arturocontreras/Paracas_Robot/Interfaz SCADA/RP_V2/WindowsFormsApplication9/Resources/images.jpg

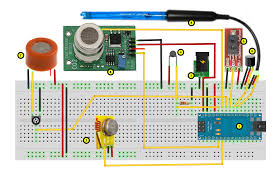
Interfaz SCADA/RP_V2/WindowsFormsApplication9/Resources/images.jpg
