arturocontreras/Paracas_Robot/Diseño Electronico/Placas/Gerber_ACS758_100A/ACS758_100A - CADCAM Bottom Solder Resist.TXT

G04 PROTEUS RS274X GERBER FILE*
%FSLAX24Y24*%
%MOIN*%
%ADD16R,0.1000X0.1000*%
%ADD14C,0.0080*%
G54D16*
X-40500Y+41500D03*
X-40500Y+40500D03*
X-40500Y+39500D03*
X-36500Y+41500D03*
X-36500Y+40500D03*
X-36500Y+39500D03*
G54D14*
X-59000Y+34500D02*
X-35000Y+34500D01*
X-35000Y+47000D01*
X-59000Y+47000D01*
X-59000Y+34500D01*
X-57500Y+35500D02*
X-57502Y+35540D01*
X-57515Y+35621D01*
X-57543Y+35702D01*
X-57588Y+35783D01*
X-57657Y+35864D01*
X-57738Y+35926D01*
X-57819Y+35966D01*
X-57900Y+35990D01*
X-57981Y+36000D01*
X-58000Y+36000D01*
X-58500Y+35500D02*
X-58498Y+35540D01*
X-58485Y+35621D01*
X-58457Y+35702D01*
X-58412Y+35783D01*
X-58343Y+35864D01*
X-58262Y+35926D01*
X-58181Y+35966D01*
X-58100Y+35990D01*
X-58019Y+36000D01*
X-58000Y+36000D01*
X-58500Y+35500D02*
X-58498Y+35460D01*
X-58485Y+35379D01*
X-58457Y+35298D01*
X-58412Y+35217D01*
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
