arturocontreras/Paracas_Robot/Diseño Electronico/Esquemas/Esquema General.pdf

r

(((

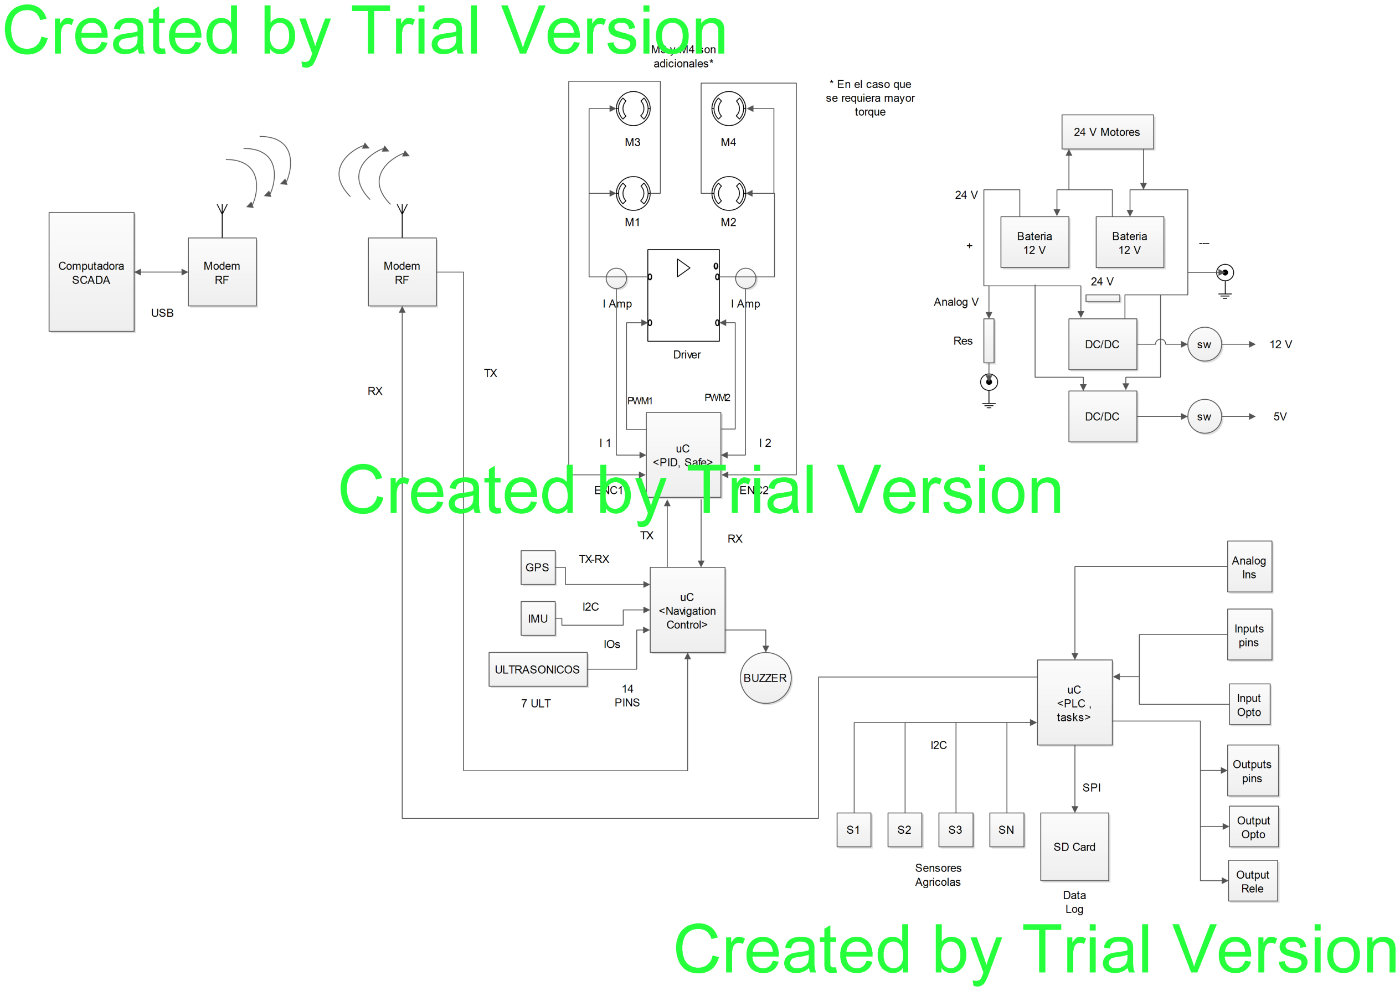
[picture p3: page 1]

SPI

Outputs
pins
'---------i | Input
Opto
,-- | ---j Inputs
pins
.--------------l | Analog Ins

Data
Log

SO Card

# Created by Trial Version

uC
<PLC,
tasks>

DCfDC

Bateria
12 V

Output
Rele

Output
Opto

5V

12 V

Bateria
12 V

Sensores
Agricolas

12C

Res

Analog V

+

24 V

24 V Motores

RX

14
7 ULT | PINS

ULTRASONICOS 1--_----'

lOs

TX

FWM2 FWM1

TX-RX

TX

* En el caso que
se requiera mayor
torque

M2

uC
<Navigation
Control>

Driver

M4

M1

# e te

Modem
RF

RX
C
Computadora | Modem
SCADA | RF

USB

# Created by Trial Versicr
