arturocontreras/Paracas_Robot/Diseño Electronico/Placas/Medidas XBEE.docx

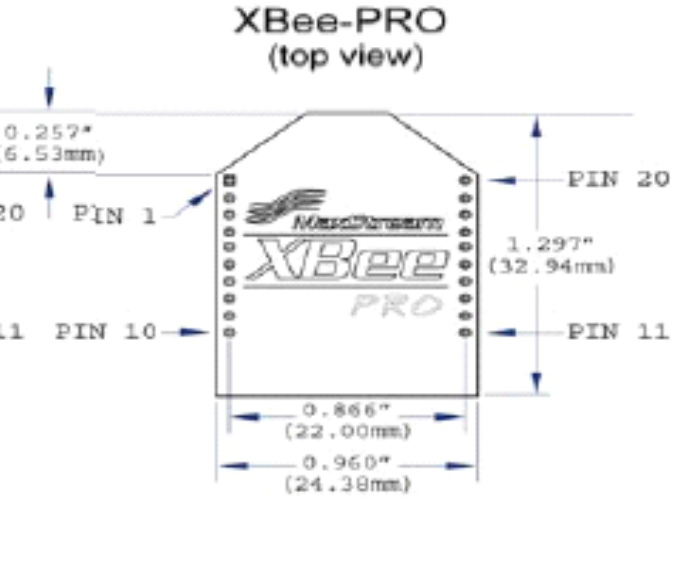
[picture p5: figure]
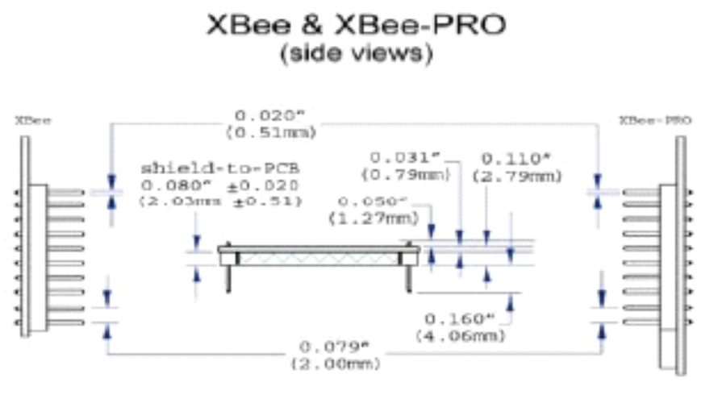
[picture p6: figure]
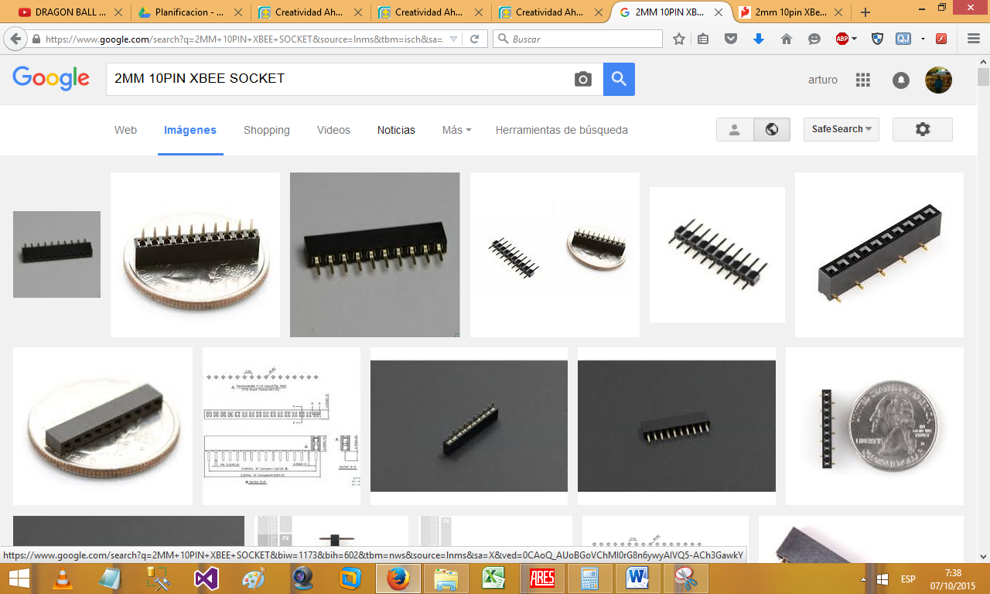
[picture p7: figure]
