arturocontreras/Paracas_Robot/Simulaciones/Modelos Motores/Matlab_motores_validacion/motor1.docx

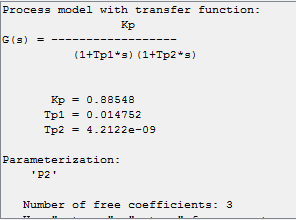
[picture p8: figure]
