arturocontreras/Paracas_Robot/Simulaciones/Modelos Motores/Matlab_motores_validacion/motor2.docx

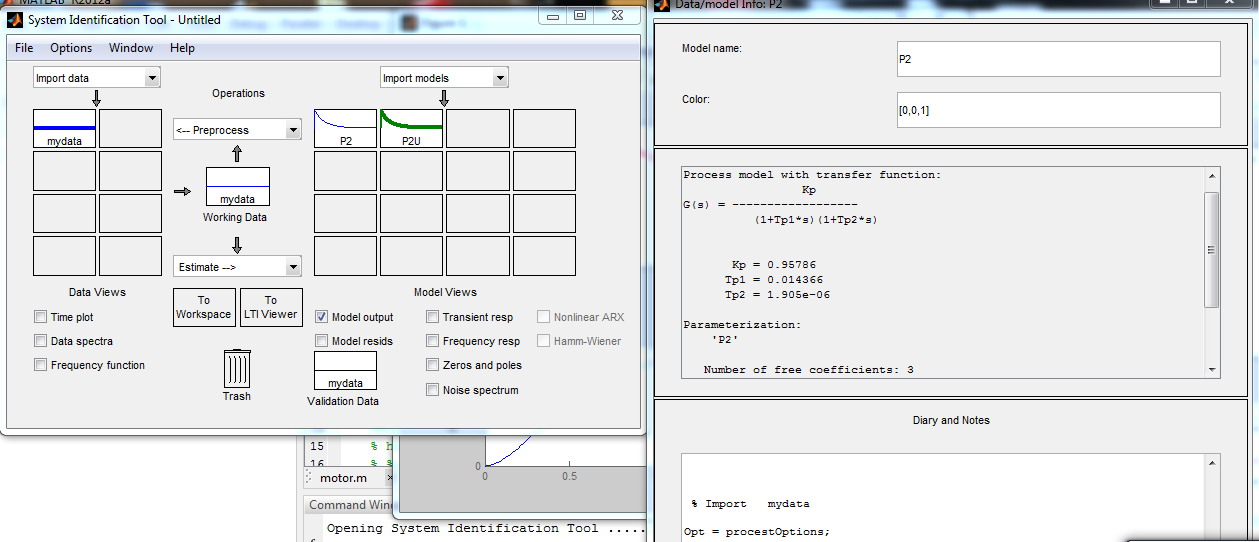
[picture p9: figure]
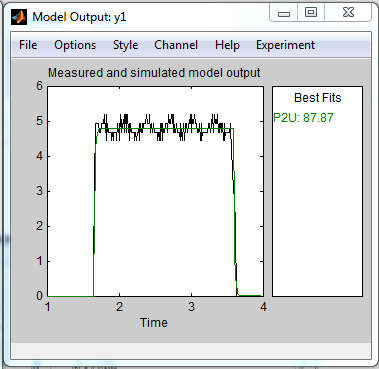
[picture p10: figure]
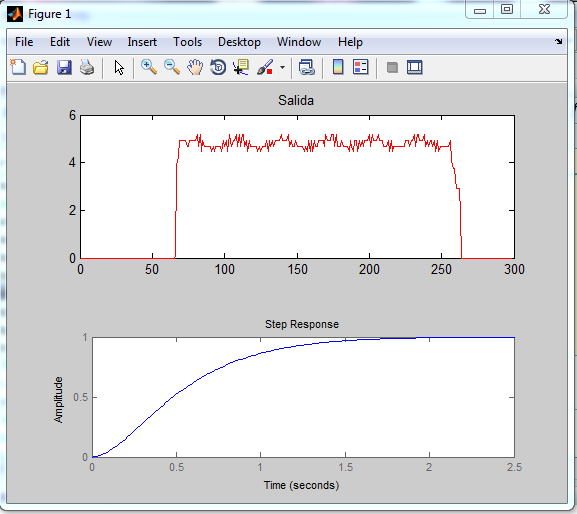
[picture p11: figure]
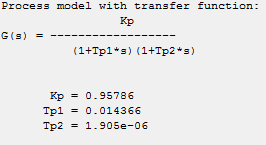
[picture p12: figure]
