arturocontreras/Paracas_Robot/Simulaciones/Modelos Motores/Matlab_motores_validacion/motor3.docx

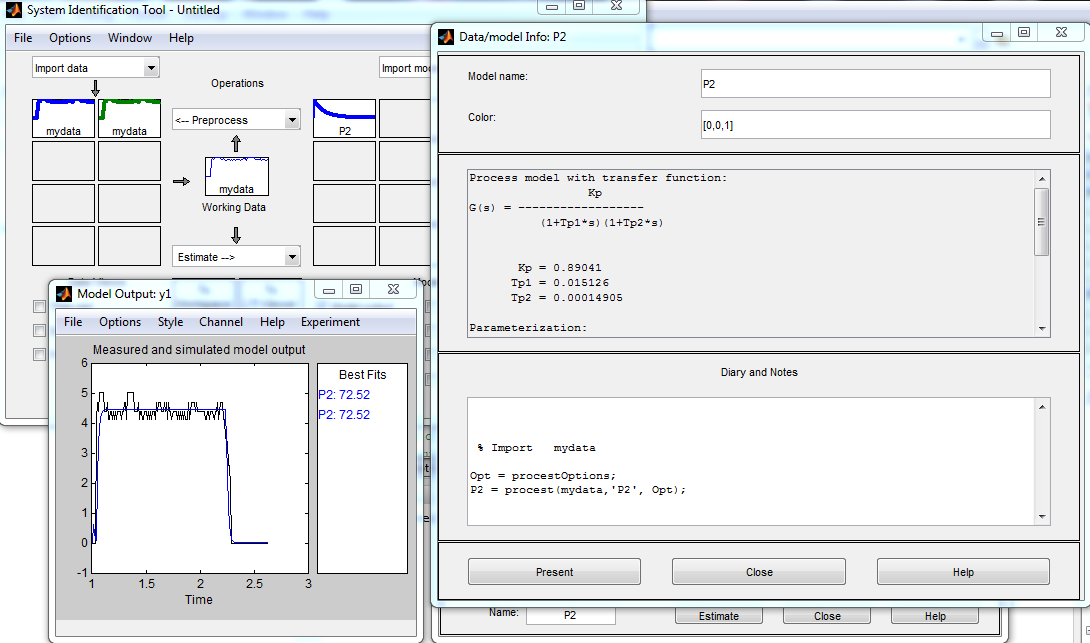
[picture p13: figure]
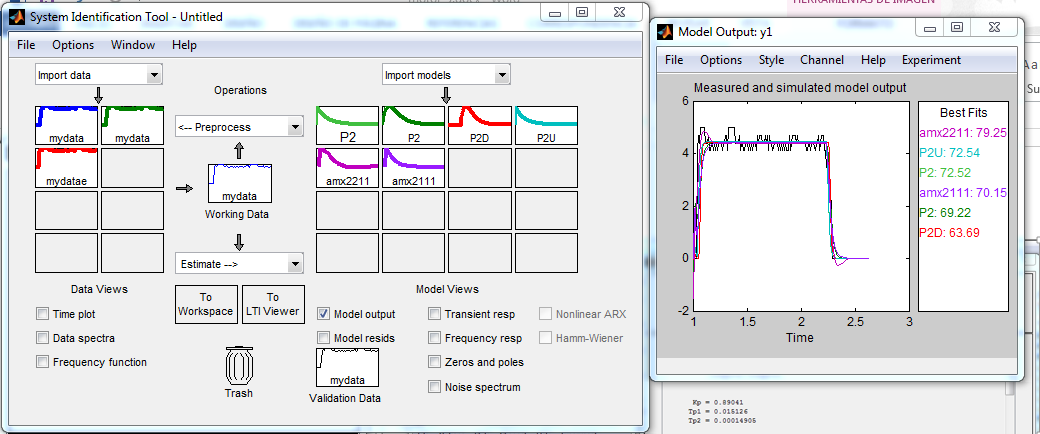
[picture p14: figure]
