arturocontreras/Paracas_Robot/Diseño Electronico/Esquemas/Esquema General Inicial.jpg

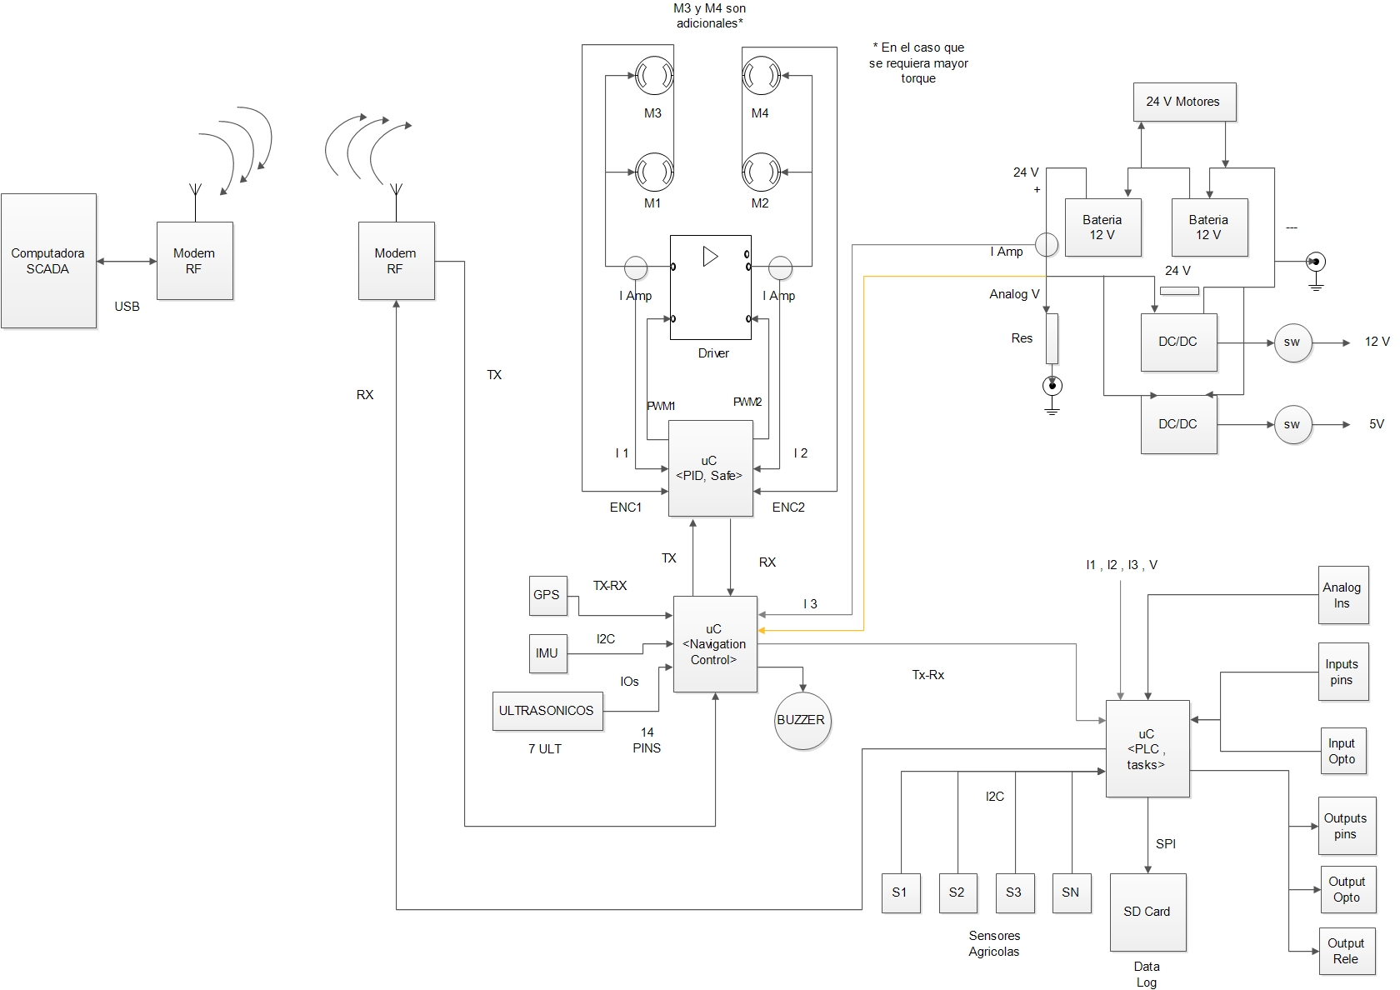
Diseño Electronico/Esquemas/Esquema General Inicial.jpg
