arturocontreras/Paracas_Robot/Interfaz SCADA/RP_V2/WindowsFormsApplication9/Resources/motor1.jpg

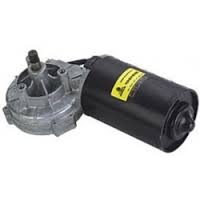
Interfaz SCADA/RP_V2/WindowsFormsApplication9/Resources/motor1.jpg
