arturocontreras/Paracas_Robot/Interfaz SCADA/RP_V2/WindowsFormsApplication9/Resources/motor pump.jpg

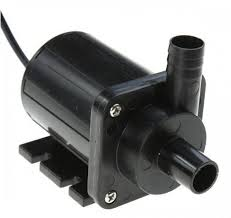
Interfaz SCADA/RP_V2/WindowsFormsApplication9/Resources/motor pump.jpg
