arturocontreras/Paracas_Robot/Interfaz SCADA/RP_V2/WindowsFormsApplication9/Resources/page3_img11.png

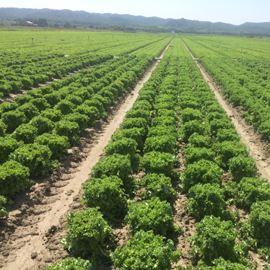
Interfaz SCADA/RP_V2/WindowsFormsApplication9/Resources/page3_img11.png
