arturocontreras/Paracas_Robot/Interfaz SCADA/RP_V2/WindowsFormsApplication9/Resources/robot_paracas.JPG

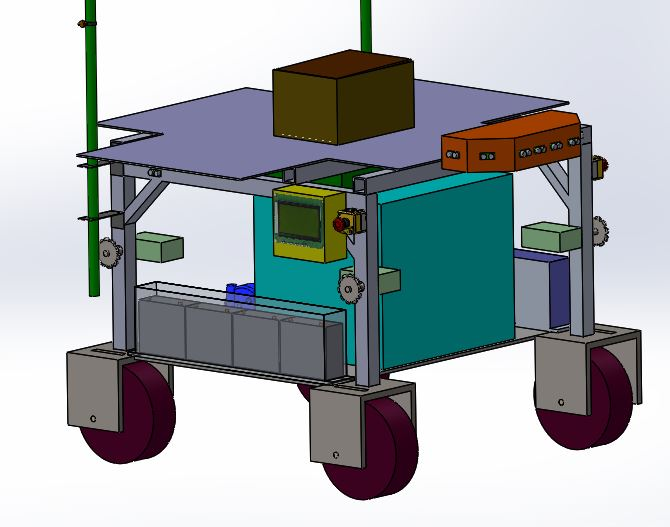
Interfaz SCADA/RP_V2/WindowsFormsApplication9/Resources/robot_paracas.JPG
