arturocontreras/Paracas_Robot/Interfaz SCADA/RP_V2/WindowsFormsApplication9/Resources/RP_campo2.jpg

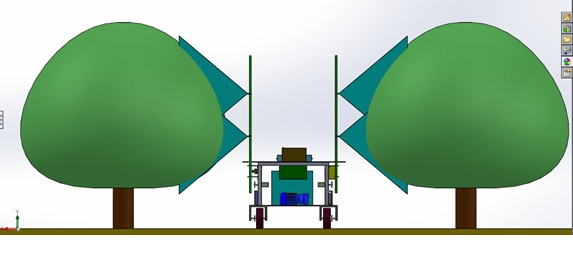
Interfaz SCADA/RP_V2/WindowsFormsApplication9/Resources/RP_campo2.jpg
