arturocontreras/Paracas_Robot/Simulaciones/Modelos Motores/Matlab_motores_validacion/html/motores_analisis_03.png

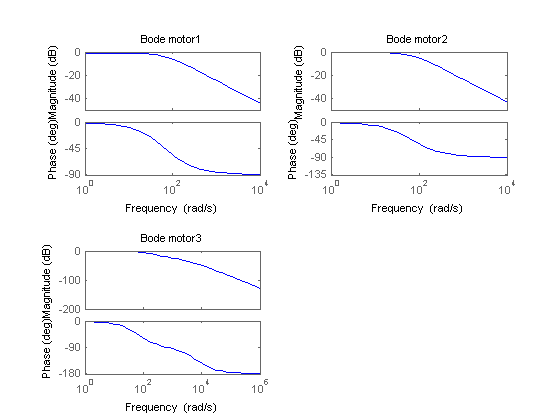
Simulaciones/Modelos Motores/Matlab_motores_validacion/html/motores_analisis_03.png
