arturocontreras/Paracas_Robot/Diseño Electronico/Placas/Lista de pines utilizados y cableado.xlsx

Sheet: C1
Controlador de Navegación | C1 | Arduino Mega
Comunicaciones UART
Dispositivo | Tipo | Nombre Serial | Pines del Arduino |  | Baudios | Tasa
 |  |  | Rx | Tx
GPS | HW | Serial3 | 15 | 14
Tareas | HW | Serial1 | 19 | 18
XBEE | HW | Serial2 | 17 | 16
PC | HW | Serial | 0 | 1
Motores | SW | motor | 53 | 52
Ultrasonicos | SW | ultra | 51 | 50
Criterio
HW | Más tasa de datos
Baudios | La mayor posible, para no generar retardos. Pero que no se pierda el sincronismo
Indicadores
Dispositivo | Tipo | Marca | Pines del Arduino
GPS | LED |  | 32
XBEE | LED |  | 30
TAREA | LED |  | 28
STOP | LED |  | 29
COORDENADAS | LED |  | 31

Sheet: C2
Controlador de Tareas | C2 | Arduino Mega
Comunicaciones UART
Dispositivo | Tipo | Nombre Serial | Pines del Arduino |  | Baudios | Tasa
 |  |  | Rx | Tx
XBEE | HW | Serial2 | 17 | 16
Tareas | HW | Serial1 | 19 | 18
Sensores
Dispositivo | Tipo | Marca | Pines del Arduino
DHT11 | Digital | Sig | 53
pH suelo | Analógico | An1 | A13
Humedad suelo | Analógico | An2 | A12
Radiación solar | Analógico | An3 | A11
Transmisor presión | Analógico | I | A14
Nivel tanque | Digital | Trig1 | 41
 |  | Echo1 | 43
U1 | Digital | Trig2 | 45
 |  | Echo2 | 47
U2 | Digital | Trig3 | 49
 |  | Echo3 | 51
Corriente total | Analógico | It | A10
Voltaje bateria | Analógico | Vol | A9
Corriente bomba | Analógico | I bomba | A8
Actuadores
Dispositivo | Tipo | Marca | Pines del Arduino
Motor actuador1 | PWM | MA1F | 5
 |  | MA1B | 6
Motor actuador2 | PWM | MA2F | 7
 |  | MA2B | 8
Motor actuador3 | PWM | MA3F | 9
 |  | MA3B | 10
Motor actuador4 | PWM | MA4F | 11
 |  | MA4B | 12
Motobomba | PWM | MB | 4
Indicadores
*Colocar LEDS en la PCB

Sheet: C3
Controlador de Motor | C3 | Arduino Mega
Comunicaciones UART
Dispositivo | Tipo | Nombre Serial | Pines del Arduino |  | Baudios | Tasa
 |  |  | Rx | Tx
Motor | HW | Serial1 | 19 | 18
Sensores
Dispositivo | Tipo | Marca | Pines del Arduino
Sensor corriente | Analogico | I1 | A3
Sensor corriente | Analogico | I2 | A2
Sensor corriente | Analogico | I3 | A1
Sensor corriente | Analogico | I4 | A0
Encoder | Int0 | A1 | 2
Encoder | Int1 | A2 | 3
Encoder | Int2 | A3 | 21
Encoder | Int3 | A4 | 20
Actuadores
Dispositivo | Tipo | Marca | Pines del Arduino
Motor1 | PWM | M1F | 7
Motor1 | PWM | M1B | 6
Motor2 | PWM | M2F | 5
Motor2 | PWM | M2B | 4
Motor3 | PWM | M3F | 11
Motor3 | PWM | M3B | 10
Motor4 | PWM | M4F | 9
Motor4 | PWM | M4B | 8
Indicadores
Dispositivo | Tipo | Marca | Pines del Arduino
Motor1 | LED | M1 | 41
Motor2 | LED | M2 | 43
Motor3 | LED | M3 | 45
Motor4 | LED | M4 | 47
Comunicaciones | LED | Com | 49

Sheet: C4
Controlador Mapeador | C4 |  | Arduino Mega
Comunicaciones UART
Dispositivo | Tipo |  | Nombre Serial | Pines del Arduino |  | Baudios | Tasa
 |  |  |  | Rx | Tx
Ultrasonico | HW |  | Serial1 | Rxu - 19 | Txu - 18
Sensores
Dispositivo | Tipo | Marca |  | Pines del Arduino
 |  | Trig | Echo
Ultrasonico1 | Digital | Trig1 | Echo1 | 45 | 47
Ultrasonico2 | Digital | Trig2 | Echo2 | 41 | 43
Ultrasonico3 | Digital | Trig3 | Echo3 | 32 | 30
Ultrasonico4 | Digital | Trig4 | Echo4 | 21 | 33
Ultrasonico5 | Digital | Trig5 | Echo5 | 28 | 29
Ultrasonico6 | Digital | Trig6 | Echo6 | 2 | 3
Ultrasonico7 | Digital | Trig7 | Echo7 | 4 | 5
Ultrasonico8 | Digital | Trig8 | Echo8 | 6 | 7
Ultrasonico9 | Digital | Trig9 | Echo9 | 8 | 9
Ultrasonico10 | Digital | Trig10 | Echo10 | 10 | 11
Ultrasonico11 | Digital | Trig11 | Echo11 | 12 | 13

Sheet: cableado
Medidas en m
 | 4 polos |  | 5 polos |  | 2 polos |  | 2polos
 | Calibre 14 |  | Calibre 14 |  | Calibre 12 |  | Calibre 8
C1 - Ultrasonicos | 0.3 | C3 - D1 | 0.5 | Bornera - C1 | 0.5 | Bornera - D1 | 0.5
C1 - GPS | 0.3 | C3 - D2 | 0.5 | Bornera - C2 | 0.5 | Bornera - D2 | 0.5
C1 - C3 | 0.3 | C3 - D3 | 0.5 | C2 - Reles | 0.2 | Bornera - D3 | 0.5
E1 - C3 | 1.5 | C3 - D4 | 0.5 | Rele - EV1 | 1.5 | Bornera - D4 | 0.5
E2 - C3 | 1.5 | C3 - D5 | 0.5 | Rele - EV2 | 1.5 | Bornera - D5 | 0.5
E3 - C3 | 1.5 |  |  |  |  | Bornera - Stop emergencia | 4
E4 - C3 | 1.5 |  |  |  |  | Bateria1 - Bornera | 2
C1 - C2 | 0.5 |  |  |  |  | Bateria2 - Bornera | 2
Bornera - C2 | 0.5
C2 - Reles | 0.2
C2 - Presion | 1.5
C2 - Nivel tank | 1.5
C2 - U1 | 1
C2 - U2 | 1
C2 - DHT11 | 0.2
C2 - pH | 2
C2 - Humedad suelo | 2
C2 - Radiacion Solar | 0.2
Total min | 17.5 |  | 2.5 |  | 4.2 |  | 10.5
Adicional 30 % | 5.25 |  | 0.75 |  | 1.26 |  | 3.15
Total | 22.75 |  | 3.25 |  | 5.46 |  | 13.65
