arturocontreras/Paracas_Robot/Interfaz SCADA/RP_V2/WindowsFormsApplication9/Resources/calibration_imu.jpg

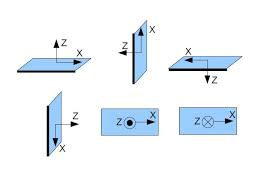
Interfaz SCADA/RP_V2/WindowsFormsApplication9/Resources/calibration_imu.jpg
