arturocontreras/Paracas_Robot/Diseño Electronico/Placas/Borneras_energia.pdf

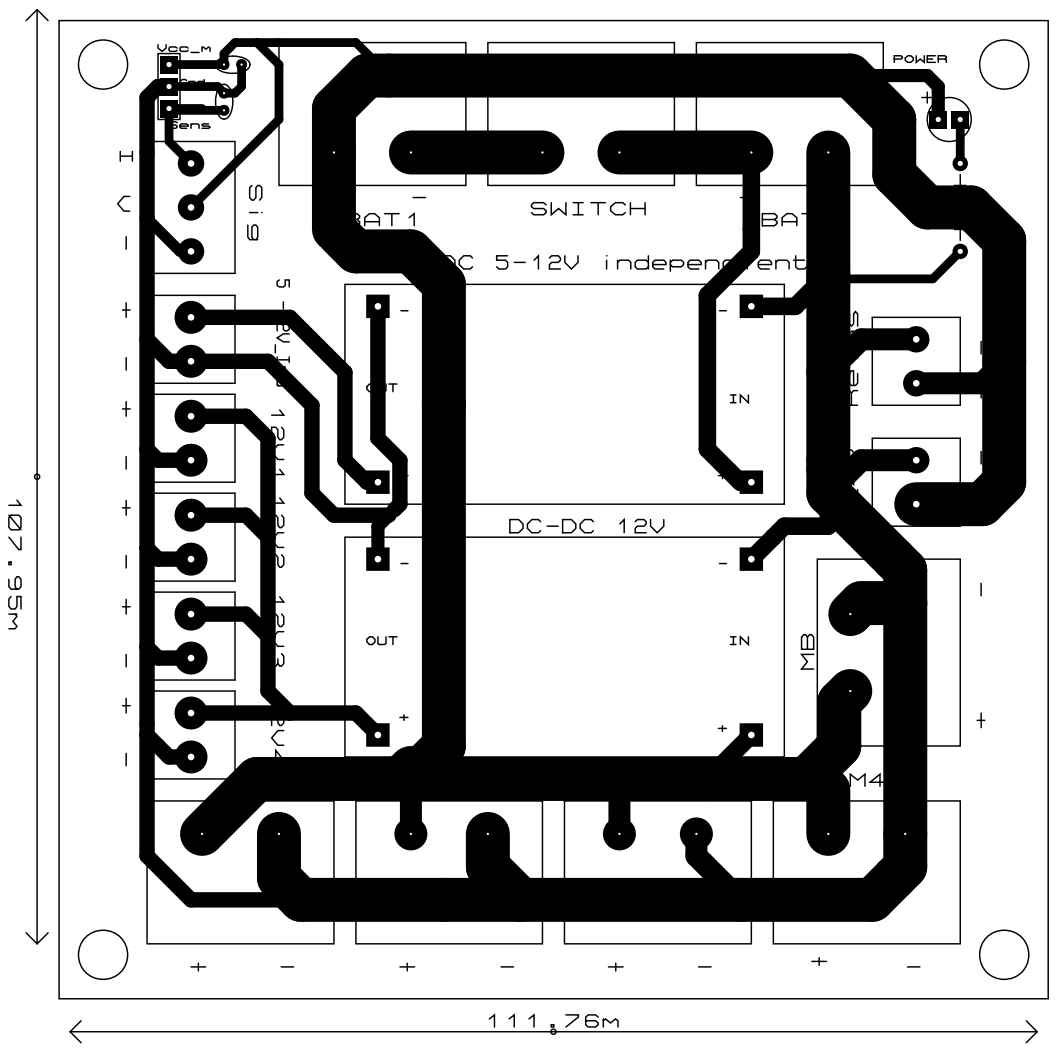
[picture p32: page 1]
