arturocontreras/Paracas_Robot/Diseño Electronico/Placas/C1_controlnav.pdf

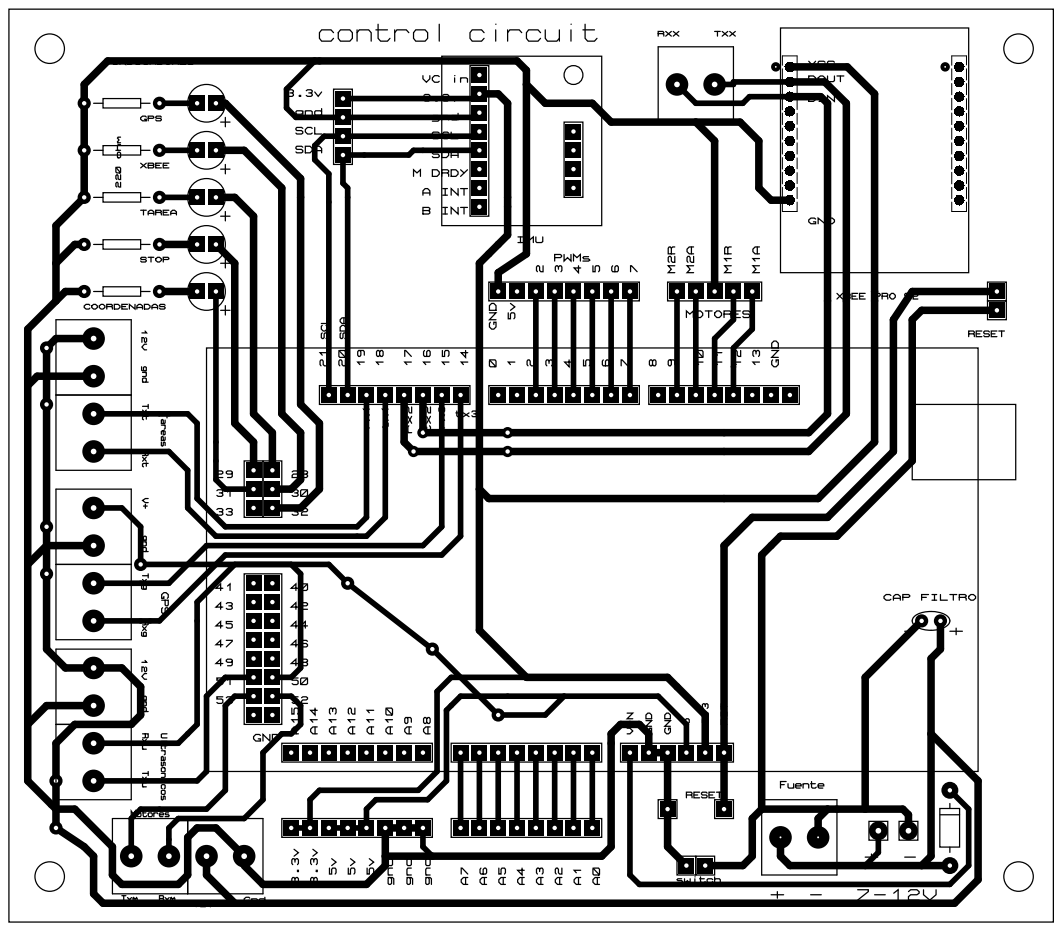
[picture p33: page 1]
