arturocontreras/Paracas_Robot/Diseño Electronico/Placas/C2_controltareasl.pdf

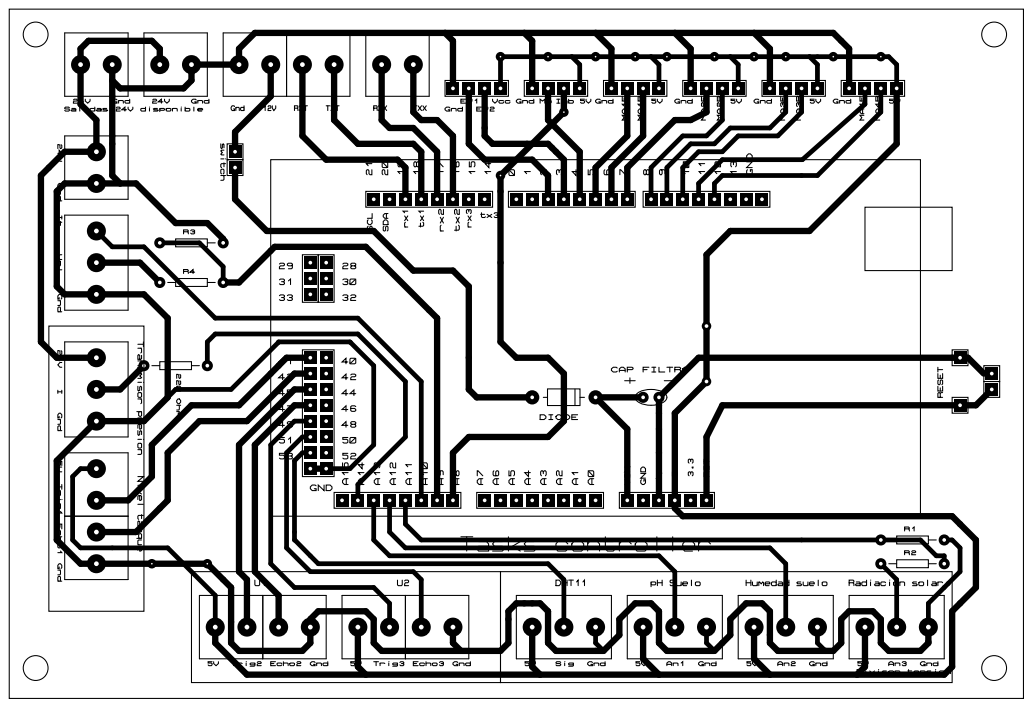
[picture p34: page 1]
