arturocontreras/Paracas_Robot/Diseño Electronico/Placas/C3_controlvel.pdf

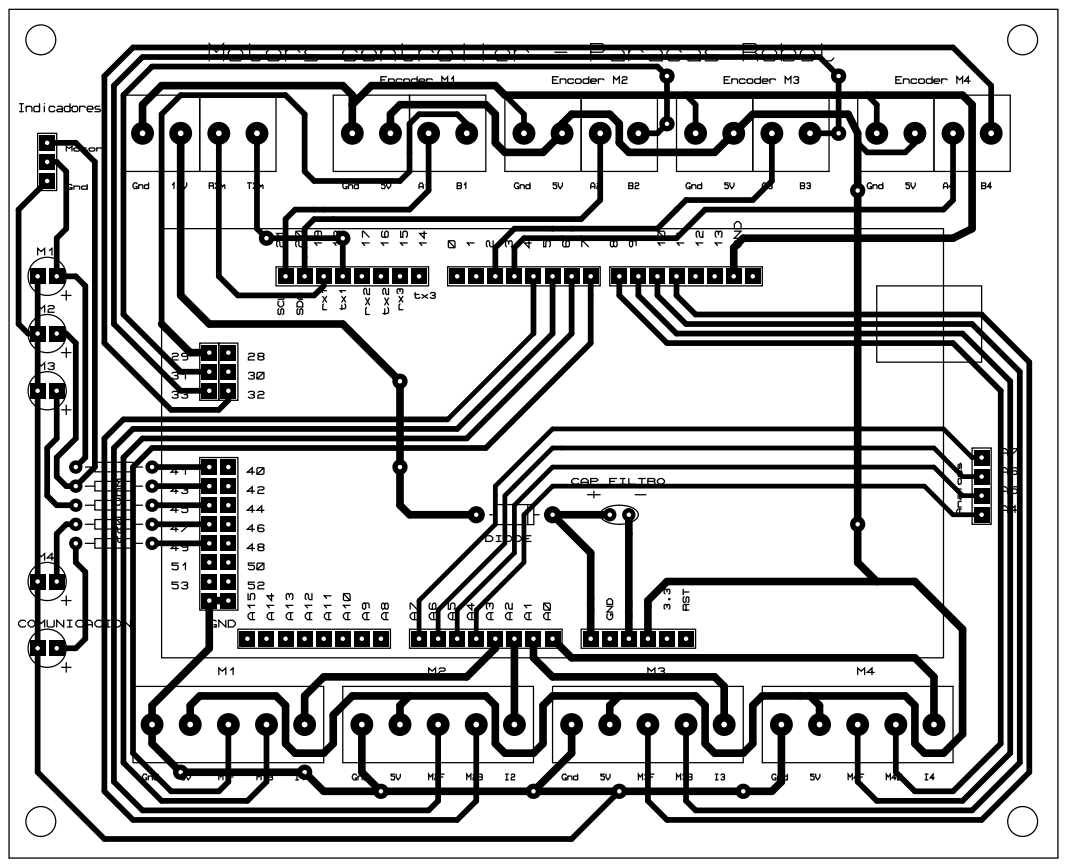
[picture p35: page 1]
