arturocontreras/Paracas_Robot/Diseño Electronico/Placas/PuenteH_v1.pdf

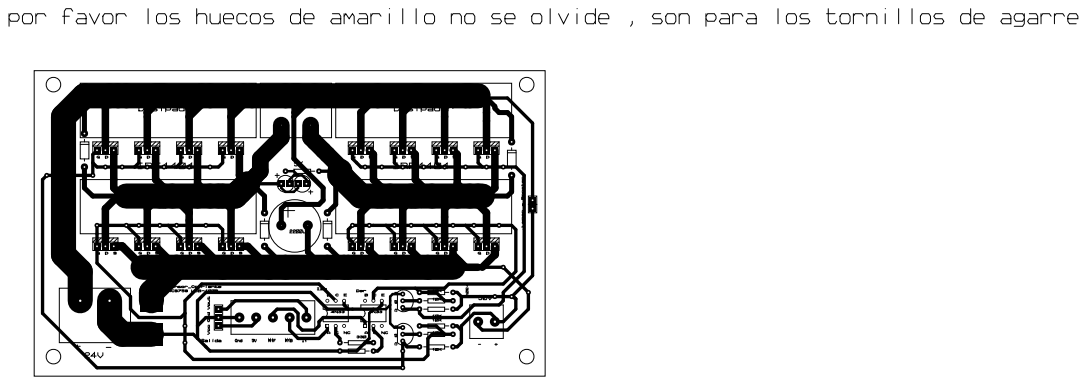
[picture p36: page 1]
