arturocontreras/Paracas_Robot/Diseño Electronico/Placas/Ultrasonicos/C4_Ultrasonicos.pdf

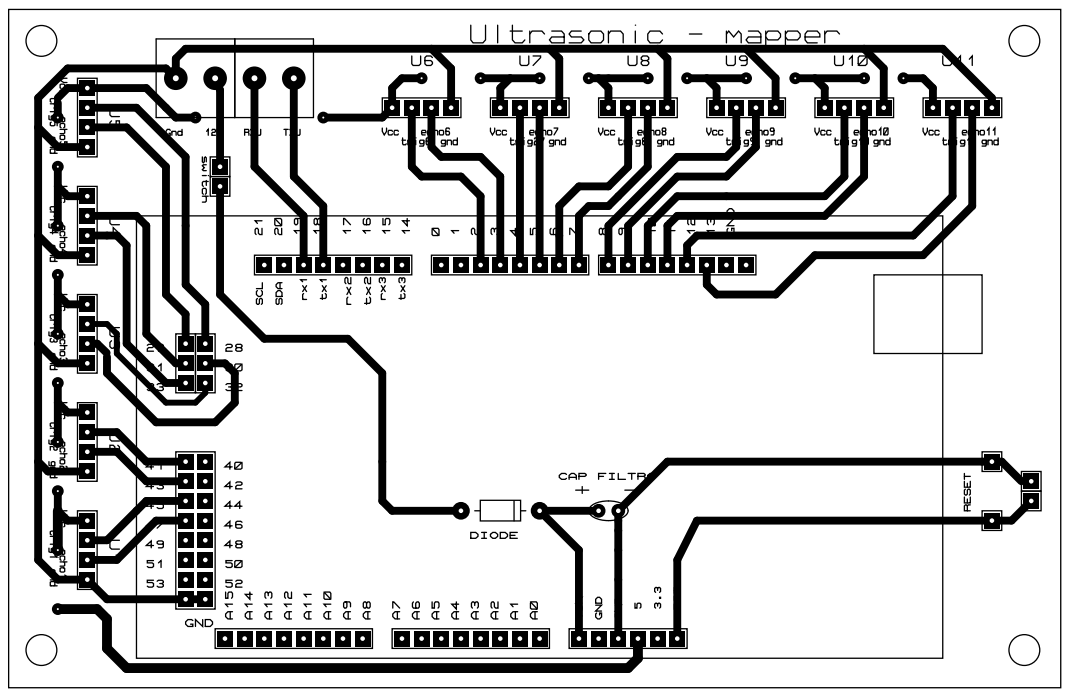
[picture p37: page 1]
