arturocontreras/Paracas_Robot/Diseño Electronico/Placas/Ultrasonicos/C4_Ultrasonicos_sin_serigrafiado.pdf

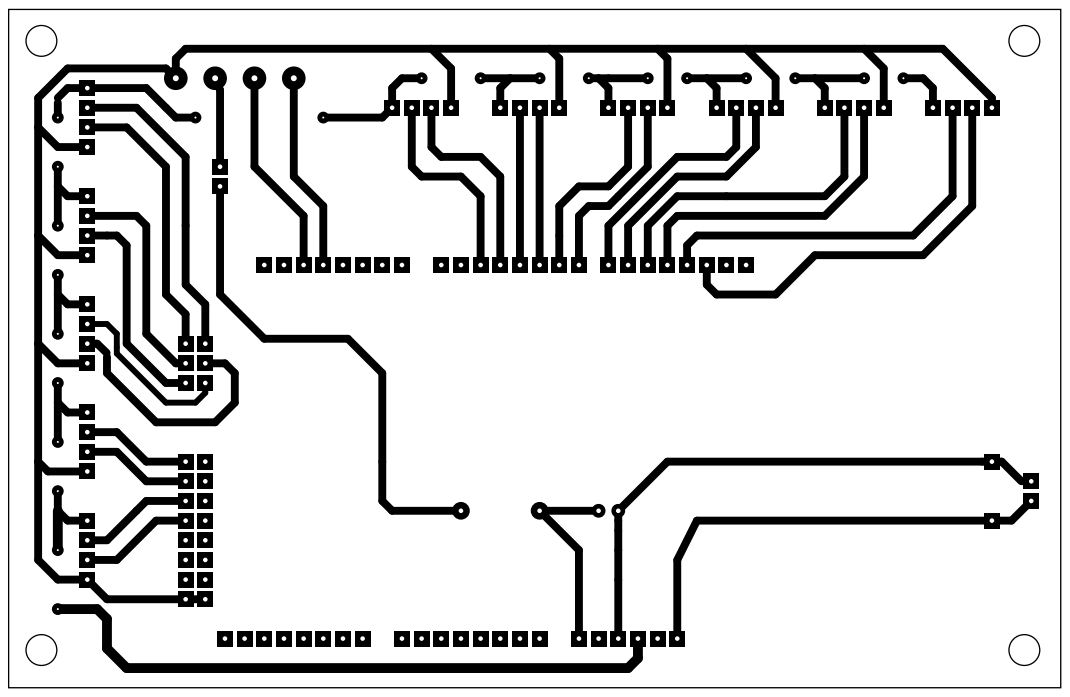
[picture p38: page 1]
