arturocontreras/Paracas_Robot/(list of files, drawings)

Other design files:
Diseño Electronico/Esquemas/Diseño electrónico - Subsistema de navegación.pdsprj
Diseño Electronico/Placas/ACS758_100A.LYT
Diseño Electronico/Placas/Borneras.LYT
Diseño Electronico/Placas/Borneras_energia.LYT
Diseño Electronico/Placas/C1_controlnav.LYT
Diseño Electronico/Placas/C2_controltareasl.LYT
Diseño Electronico/Placas/C3_controlvel.LYT
Diseño Electronico/Placas/GPS&RF.LYT
Diseño Electronico/Placas/PuenteH_v1.LYT
Diseño Electronico/Placas/Sensor_corriente.LYT
Diseño Electronico/Placas/Ultrasonicos/C4_Ultrasonicos.LYT
Diseño Electronico/Simulaciones_Drivers/driver1.DSN
Diseño Electronico/Simulaciones_Drivers/driver2.DSN
Diseño Electronico/Simulaciones_Drivers/Mosfet.DSN
